Fredovsky/B13B-Nixie-clock/README.md

# B13B-Nixie-clock
Nixie clock made from F9057 Nixie tubes (B13B sockets).
