Fredovsky/B13B-Nixie-clock/Hardware/Nixie Clock Components V1 SMDPSU.xlsx

Nomenclature | Description | Package | Quantity | Part Number | Alternative PN | Pileofpoo Nomenclature
12V | Power Jack 2mm - D6.5mm |  | 1 | PJ-044A
C1 | 0.01uF 50V 10% Ceramic | 0603 | 1 | 885382206002 | C0603C103K5RAC7411 | C3
C2 | 680pF 50V 10% Ceramic | 0603 | 1 | C0603C681K5RACTU | CC0603KRX7R9BB681 | C2
C3-C10, C13-C15 | 0.1uF 25V | 0603 | 11 | 06033C104KAT4A | 06033G104ZAT4A
C11 | 10uF 25V | 0603 | 1 | GRM188R61E106KA73D | GRM188R61A106ME69D
~~C12~~ | ~~3.3uF 200V Al Electrolytic~~ | ~~Pitch 2.5mm x D6.3 x L11.2~~ | ~~1~~ | ~~ECA-2DM3R3~~ |  | ~~C4~~
C12 | 3.3uF 200V Al Electrolytic | SMD D8 L10 | 1 | UUX2D3R3MNL1GS |  | C4
C16 | 0.22uF 25V Ceramic | 0603 | 1 | 885012206073 | C1608X7R1E224K080AC
~~C17~~ | ~~220uF 25V Low ESR Electrolytic~~ | ~~Pitch 3.5mm xD8 x L11.5~~ | ~~1~~ | ~~EEU-FM1E221~~ |  | ~~C1~~
C17 | 220uF 25V Low ESR Electrolytic | SMD 6.6x6.6xH7.7 | 1 | EMZR250ADA221MF80G |  | C1
C18 | 100uF 25V decoupling capacitor | SMD 6.6x6.6xH7.7 | 1 | 865080545012
D1 | Small Signal Silicon Diode 4nS 1N4148 | SOD-123 | 1 | 1N4148W-7-F | 1N4148W-E3-18 | D2
~~D2~~ | ~~250PRV Ultra Fast Rectifier 50nS~~ | ~~SOD-123~~ | ~~1~~ | ~~BAV21HWFQ-7~~ | ~~BAV21W-E3-08~~ | ~~D1~~
D2 | 250PRV Ultra Fast Rectifier 50nS | TO-252-3 | 1 | RFN10BM3STL |  | D1
IC1 | 8bit Microcontroller | TQFP-32 | 1 | ATMEGA328P-AU
IC2 | 5V Voltage regulator | SOT223 | 1 | LM340MP-5.0/NOPB | LM7805MPX/NOPB
IC3 | 5V-12V CMOS Level shifter | TSSOP16 | 1 | CD4504BPWR | CD4504BPWE4
IC4 | Switch Mode Controller | SOIC8 | 1 | MC34063ADR | MC34063ADG | U1
ICSP | 2x3 0.1inch pin header |  | 1 | 61300621121 | TSW-103-24-L-D
JP1-JP3 | 2x8 0.1inch pin header male |  | 3 | 61301621121
JP1-JP3* | 2x8 0.1inch pin header female |  | 3 | 929852-01-08-RA | 803-87-016-10-001101
~~L1~~ | ~~100uH 1.4A Drum Core Inductor~~ | ~~Pitch 5mm x D9x L12.2~~ | ~~1~~ | ~~RLB9012-101KL~~ |  | ~~L1~~
L1 | 100uH 1.4A Drum Core Inductor | SMD 11x10xH4.8 | 1 | SDR1105-101KL |  | L1
~~Q1~~ | ~~60V PNP Transistor~~ | ~~TO-92 - Kinked leads~~ | ~~1~~ | ~~KSP2907ATA~~ | ~~KSP2907ACTA~~ | ~~Q2~~
Q1 | 60V PNP Transistor | SOT-23-3 | 1 | MMBT2907A-7-F |  | Q2
~~Q2~~ | ~~200V Power N-FET IPAK Height above PCB <10mm~~ | ~~TO251~~ | ~~1~~ | ~~IRFU220BTU-AM002~~ | ~~IRFU220NPBF~~ | ~~Q1~~
Q2 | 200V Power N-FET IPAK Height above PCB <10mm | TO-252-3 | 1 | IRFR220PBF |  | Q1
XTAL | 16Mhz 15pF Resonator |  | 1 | CSTNE16M0V530000R0
R1 | 13.7K 1/4W 1% | 1206 | 1 | CRCW120613K7FKEA | CR1206-FX-1372ELF | R4
R2 | 1K 1/4W 5% | 1206 | 1 | ERJ-8ENF1001V | CRCW12061K00FKEA | R3
R3 | 4.02K 1/4W 1% | 1206 | 1 | ERJ-8ENF4021V | CRCW12064K02FKEA | R6
R4 | 475K 1/4W 1% | 1206 | 1 | ERJ-8ENF4753V | RC1206FR-07475KL | R5
R5, R6 | 0.5Ohm 1/4W 5% | 1206 | 2 | RCWE1206R500FKEA | 560050332013 | R1, R2
R7, R10-R17 | 10K | 0603 | 9 | ESR03EZPJ103 | ESR03EZPF1002
~~R10~~ | ~~1K for safe luminance detection~~ | ~~0603~~ | ~~1~~ | ~~CRCW06031K00FKEAC~~ | ~~CRCW06031K00FKEA~~
R8, R9, R18, R19 | 4.7K | 0603 | 4 | ERJ-3EKF4701V | CRCW06034K70JNEBC
RX | 680Ohm 1% | 1206 | 1 | ERJ-UP8F6800V | CRCW1206680RFKEAC | RX
S1, S2, S3 | Tactile Switch, height>10mm |  | 3 | TL1105SPF160Q | TL1105SPF100Q
Switch cap | Tall black cap |  | 3 | 1RBLK
T1 | Ambiant Light Sensor |  | 1 | TEPT5700
U1, U2 | Tube driver | PQFP-44 | 2 | HV5530PG-G
RTC | Real Time Clock | SOIC16 | 1 | DS3231S#T&R
BAT | CR2032 Battery holder | SMD | 1 | BAT-HLD-001
RA1-RA4 | Anode Resistor 56k (or 47K or 30K) 2W 200V | 2010 | 4 | 350256KFT
Pins | Nixie to PCB pin (aliexpress/ebay) |  | 52
12V power adapteur | Plug 5.5mm x 2mm |  | 1 | SWI25-12-E-P5
M3 Standoffs (11mm) | Spacer for back board to control board |  | 2 | M2146-3005-AL
M4 Spacers (3mm) | Spacer for Nixie board to front wood | L3 Di 4.3 Do 6mm | 3 | M0532-4-AL
Hardware
Rubber feet | Hemispherical |  | 2 | SJ-5003
M4 Wood inserts | M4x8mm brass wood inserts |  | 3
M3x18screws | M3 for back board mount |  | 2
M4x12 screws | M4x12 |  | 3
M3 nuts |  |  | 2
CR2032 Battery |  |  | 1
