Fredovsky/B13B-Nixie-clock/Nixie Clock v1.1/3D Files/Nixie Clock for 3D Print v1.1.step

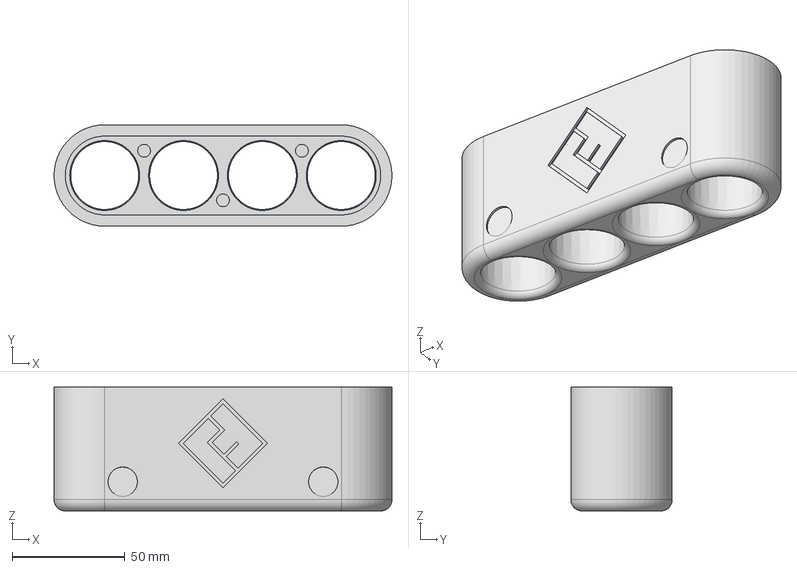
[picture p1: CAD file, 2025-10-16]
Nixie Clock v1.1/3D Files/Nixie Clock for 3D Print v1.1.step
150.0 x 45.0 x 55.0 mm
