Fredovsky/B13B-Nixie-clock/(list of files, cad)

Other CAD files:
Nixie Clock v1.1/3D Files/Nixie Clock for 3D Print v1.1.f3d
Nixie Clock v1.1/3D Files/Nixie Clock for 3D Print v1.1.stl
