Fredovsky/B13B-Nixie-clock/Nixie Clock v1.1/PCB/KiCAD project/ControllerBoardSMDPSU.kicad_pcb

## KiCad design Nixie Clock v1.1/PCB/KiCAD project/ControllerBoardSMDPSU.kicad_pcb (2025-10-16)

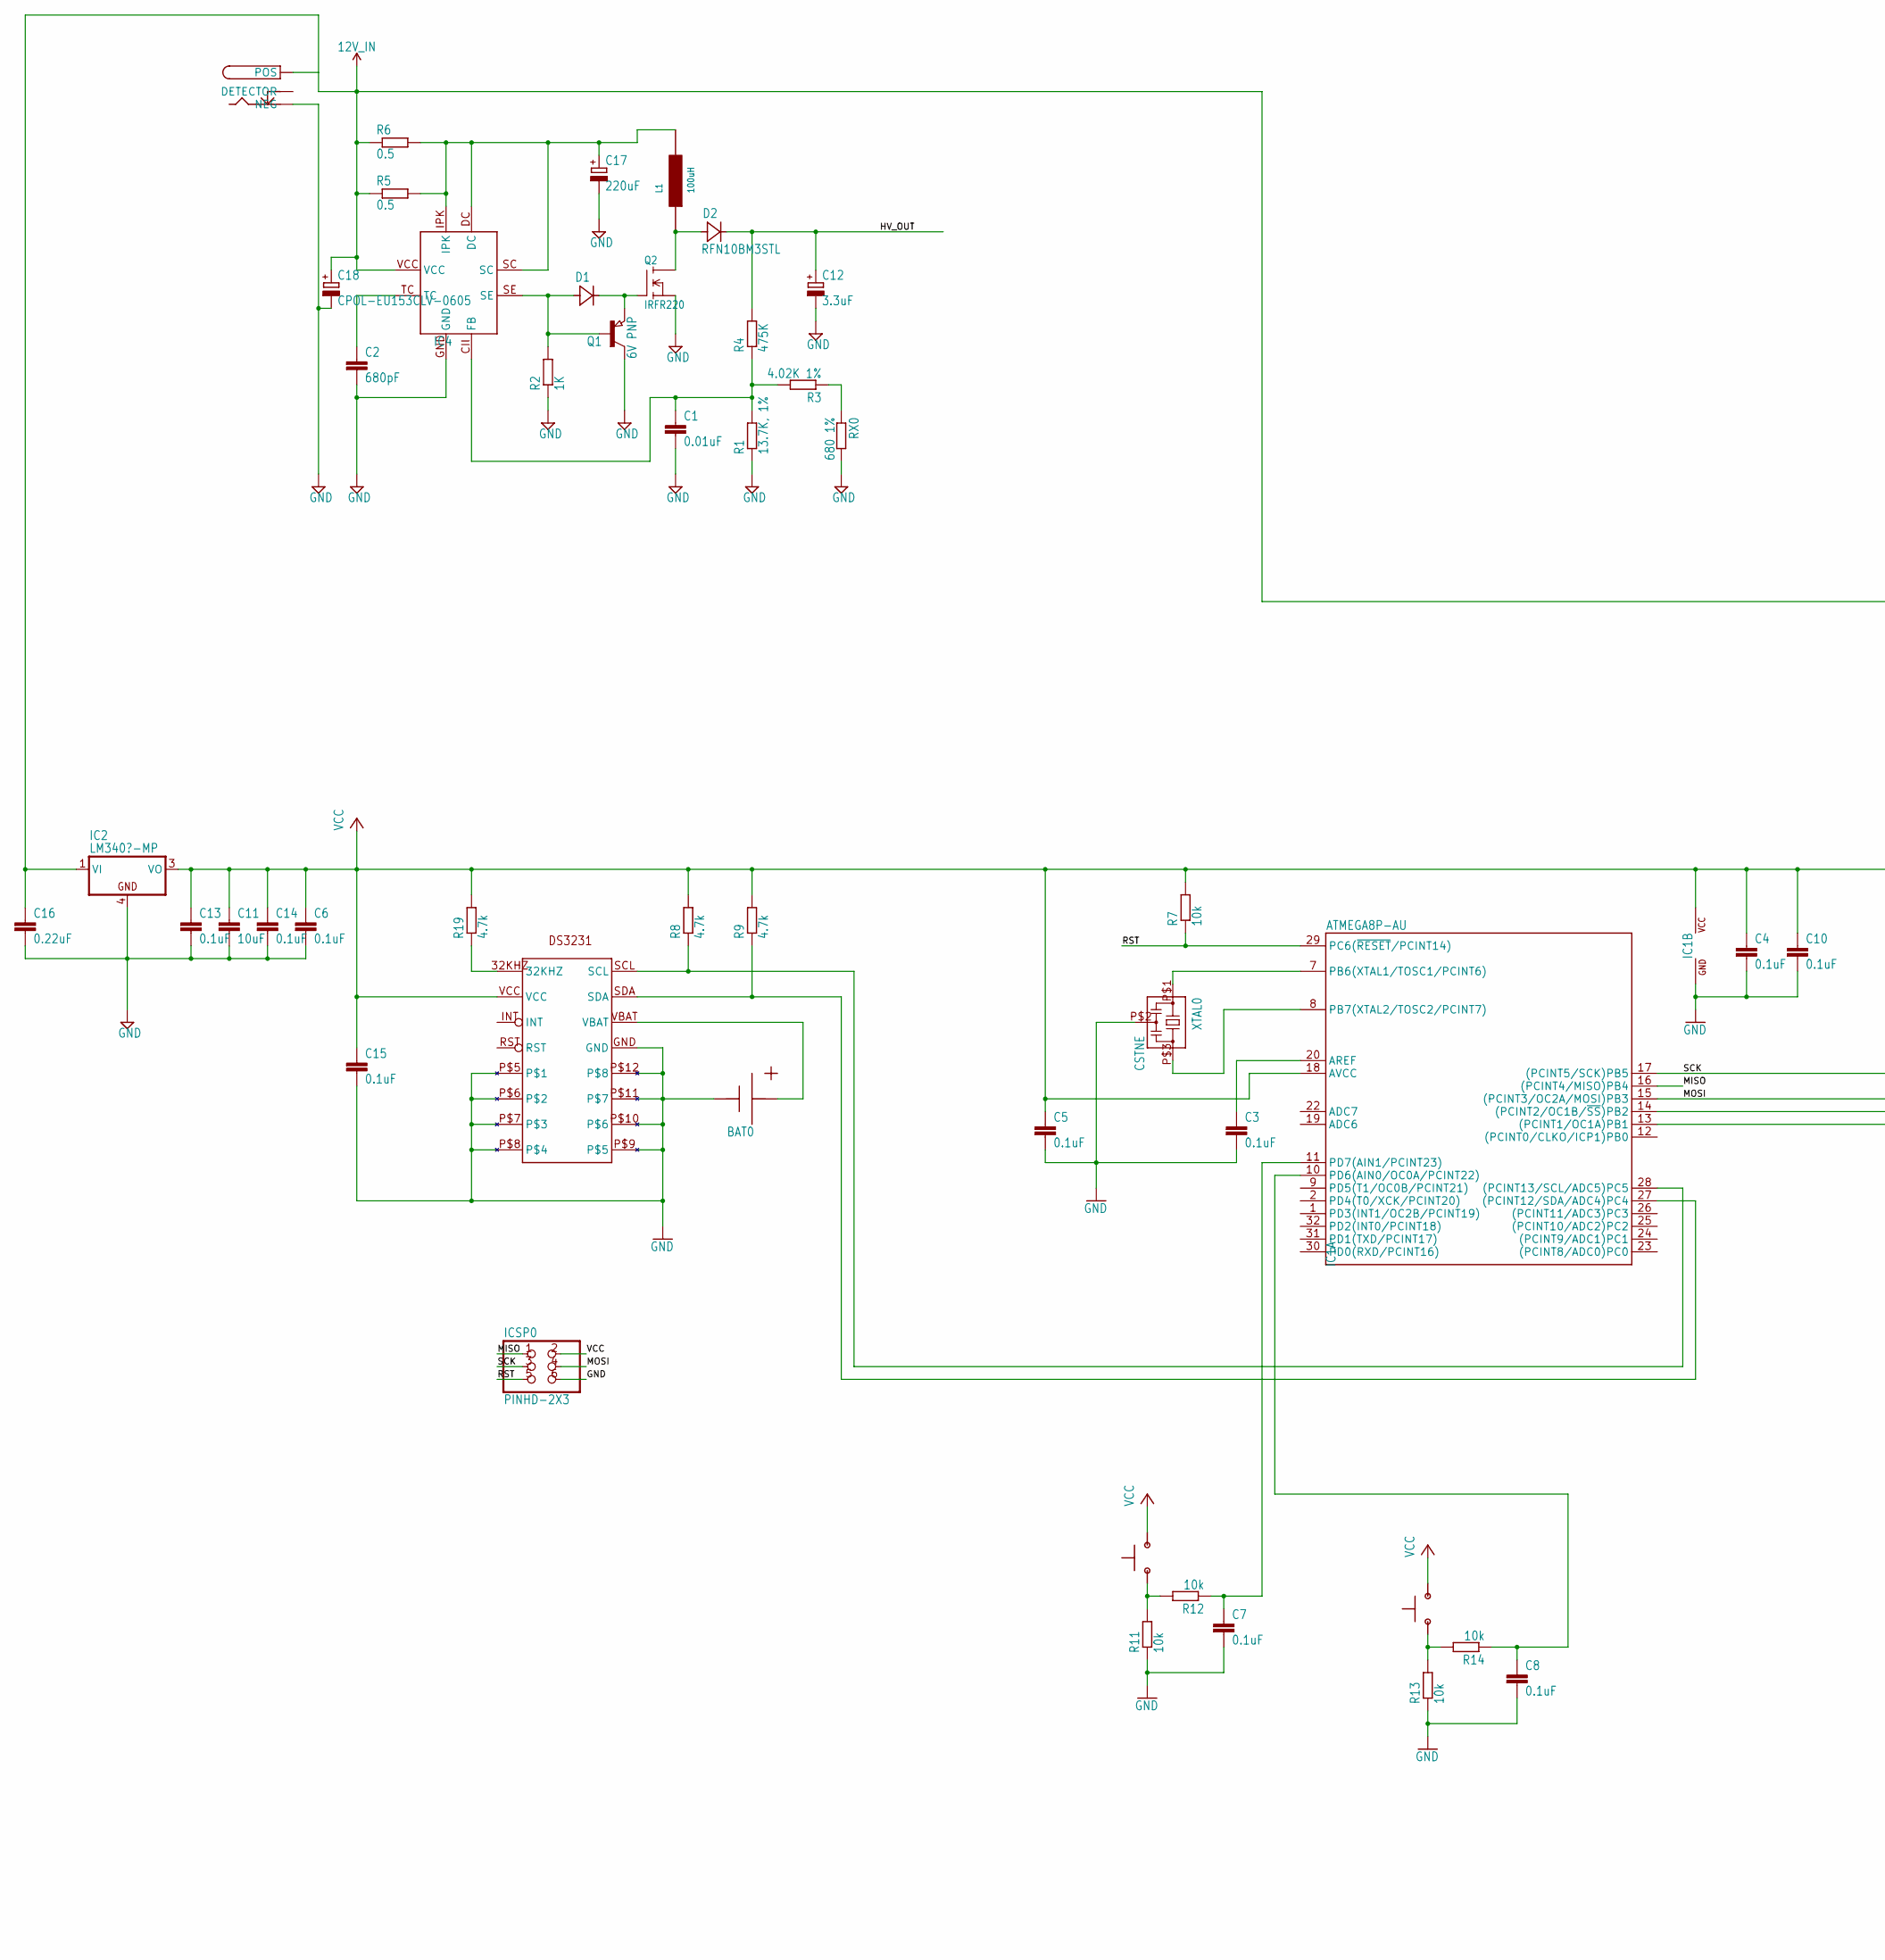
[picture p5: schematic ControllerBoardSMDPSU.kicad_sch, part in row 1, column 1]

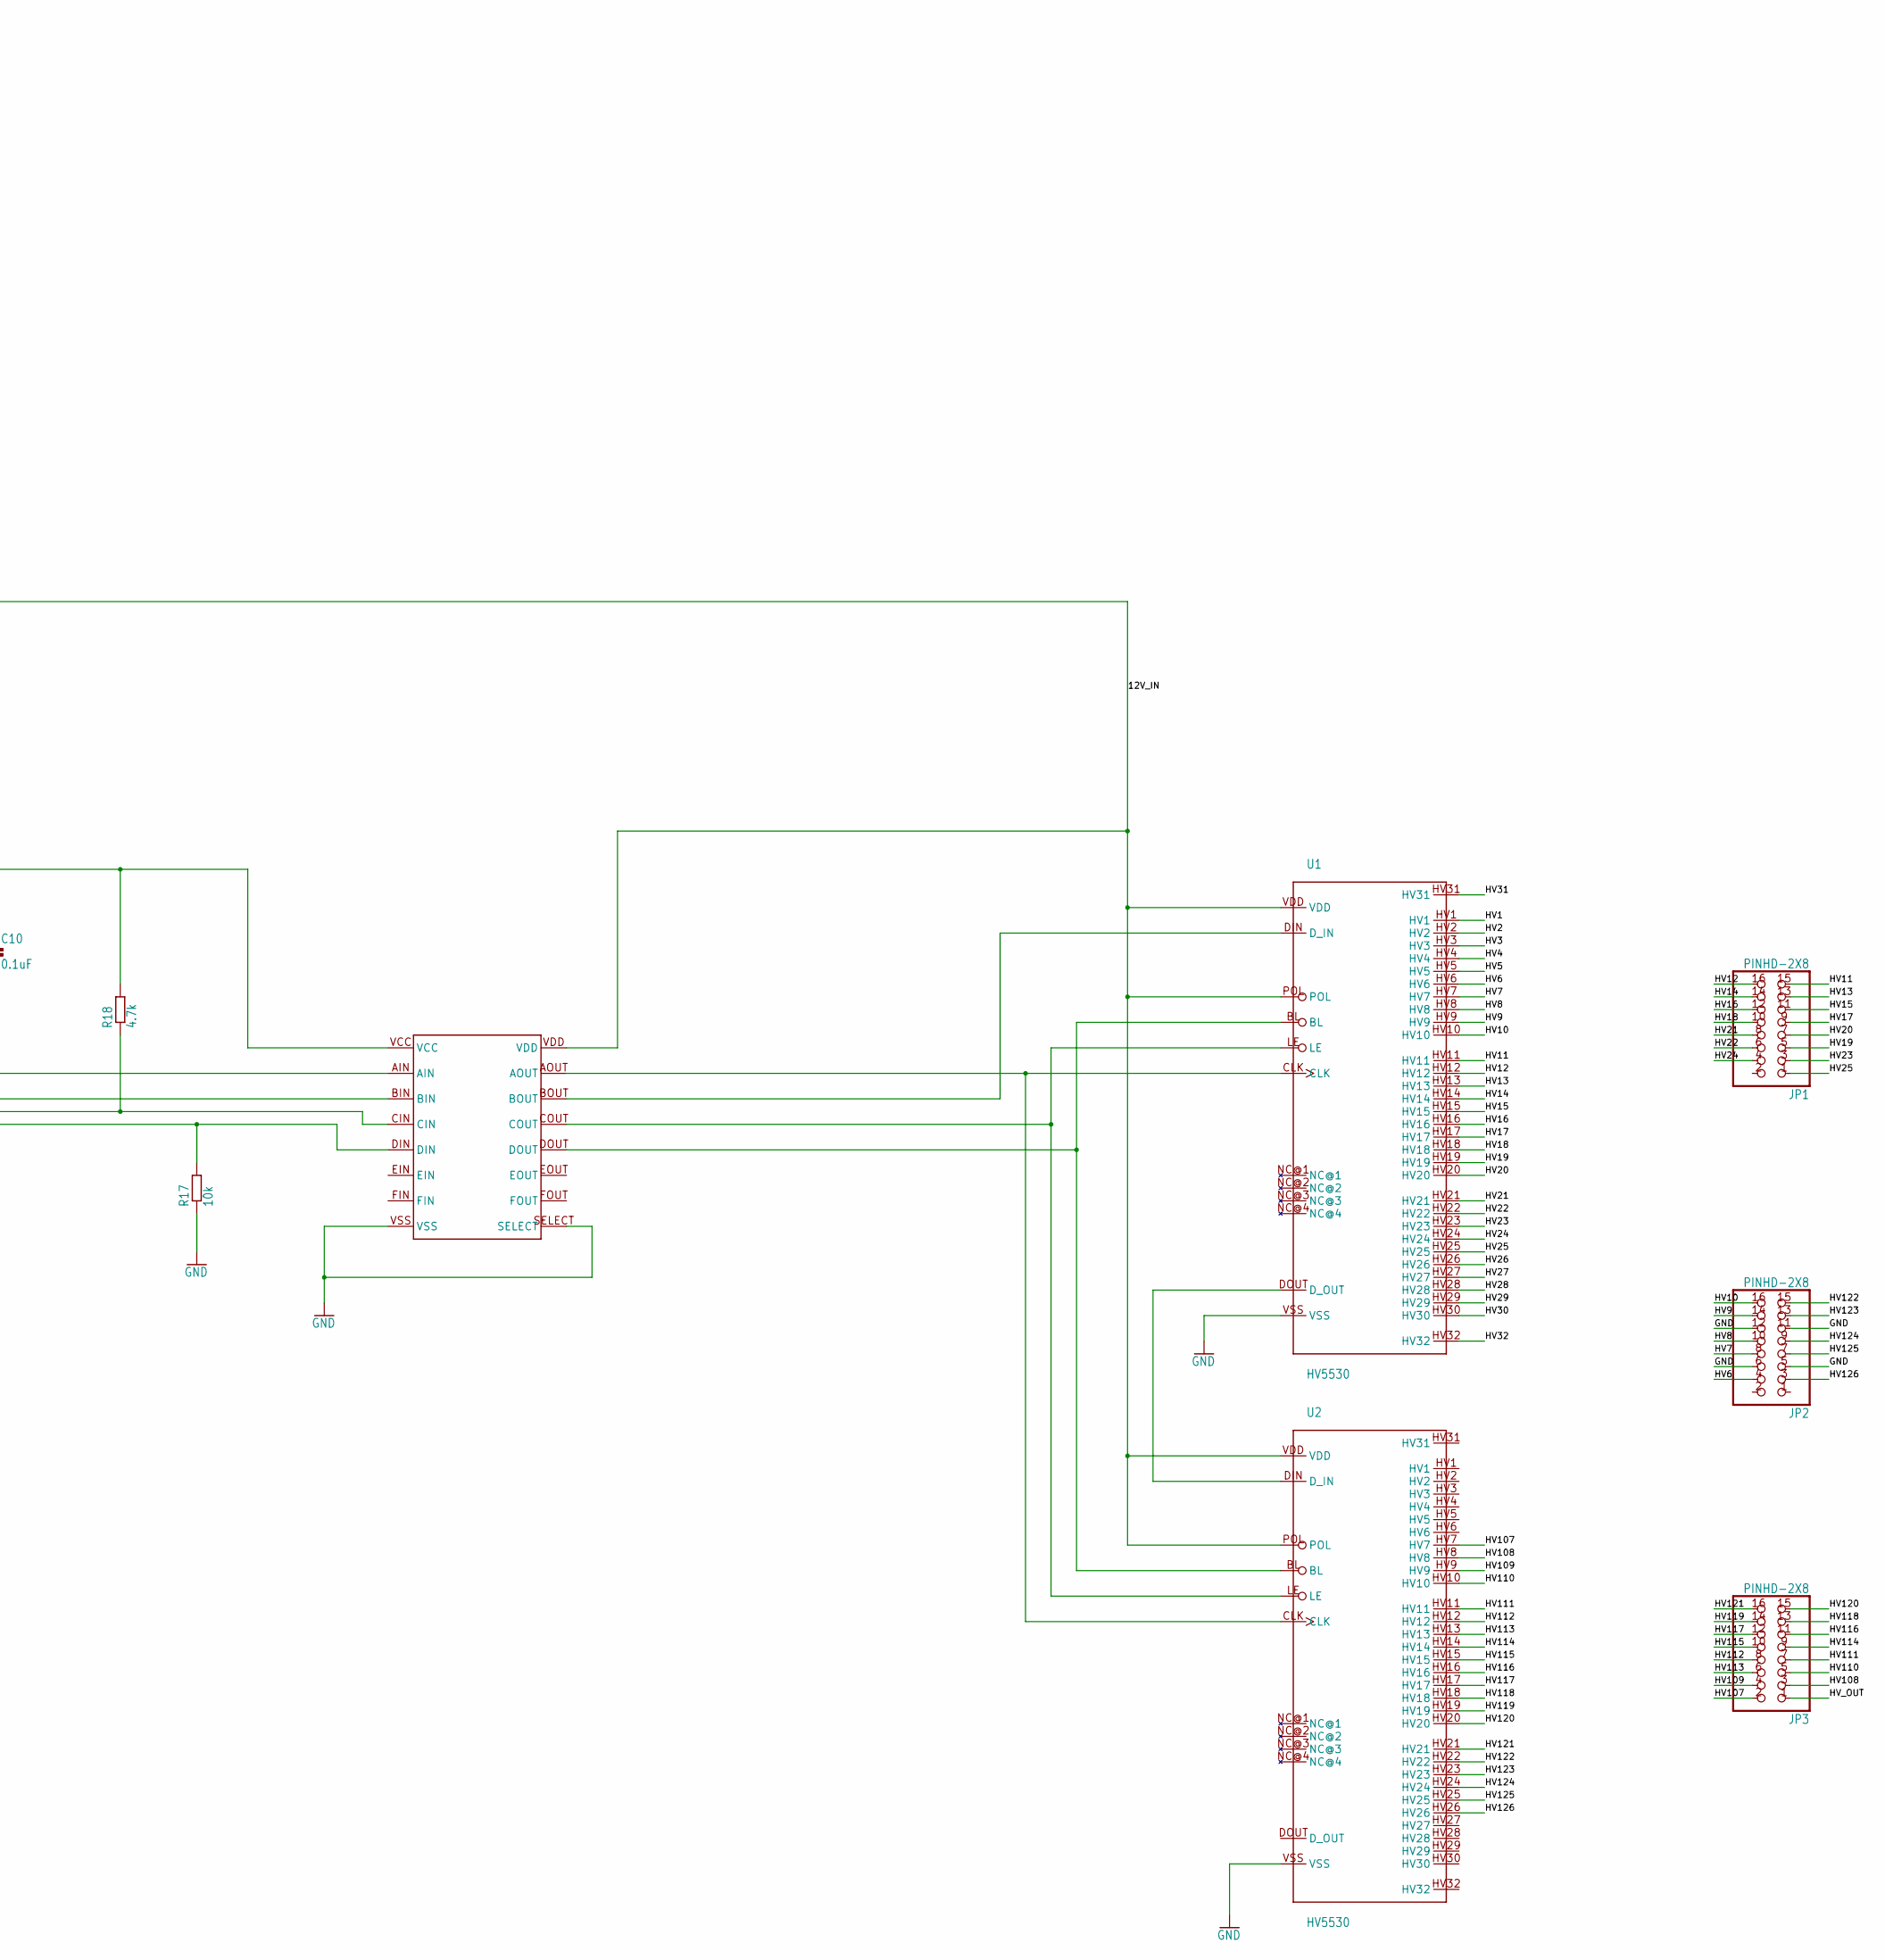
[picture p6: schematic ControllerBoardSMDPSU.kicad_sch, part in row 1, column 2]

Parts:
BAT0: CR2032-SMD-HLDR; CR2032-SMD
C1: 0.01uF; C0603
C2: 680pF; C0603
C3, C4, C5, C6, C7, C8, C10, C13, C14, C15: 0.1uF; C0603
C11: 10uF; C0603
C12: 3.3uF; 153CLV-0810
C16: 0.22uF; C0603
C17: 220uF; 153CLV-0605
C18: CPOL-EU153CLV-0605; 153CLV-0605
D1: SOT123DIODE; SOD123
D2: RFN10BM3STL; TO252
IC1: ATMEGA8P-AU; QFP32_7X7_0.80
IC2: LM340?-MP; SOT223
IC3: CD4504BTSSOP16; SOP65P640X120-16N
IC4: MC34063; SOIC127P600X175-8
ICSP0: PINHD-2X3; 2X03
JP1, JP2, JP3: PINHD-2X8; 2X08
L1: 100uH; SDR1105
Q1: 6V PNP; SOT23
Q2: IRFR220; DPAK
R1: 13.7K, 1%; R1206
R2: 1K; R1206
R3: 4.02K 1%; R1206
R4: 475K; R1206
R5, R6: 0.5; R1206
R7, R11, R12, R13, R14, R17: 10k; R0603
R8, R9, R18, R19: 4.7k; R0603
RTC0: DS3231-CORRECT; SOIC16-CORRECT
RX0: 680 1%; R1206
S1, S2: TL1105
U1, U2: HV5530; 44_PQFP_CORRECTED
UNK12V0: CUI_PWR_JACK
XTAL0: CSTNE

Connections:
12V_IN: C16.1, C18.+, IC2.1 (VI), IC3.VDD, IC4.VCC, R5.1, R6.1, U1.POL, U1.VDD, U2.POL, U2.VDD, UNK12V0.POS, UNK12V0.POS1 (POS); also elsewhere on the board
/HV1: U1.HV1
/HV2: U1.HV2
/HV3: U1.HV3
/HV4: U1.HV4
/HV5: U1.HV5
/HV6: JP2.4, U1.HV6
/HV7: JP2.8, U1.HV7
/HV8: JP2.10, U1.HV8
/HV9: JP2.14, U1.HV9
/HV10: JP2.16, U1.HV10
/HV11: JP1.15, U1.HV11
/HV12: JP1.16, U1.HV12
/HV13: JP1.13, U1.HV13
/HV14: JP1.14, U1.HV14
/HV15: JP1.11, U1.HV15
/HV16: JP1.12, U1.HV16
/HV17: JP1.9, U1.HV17
/HV18: JP1.10, U1.HV18
/HV19: JP1.5, U1.HV19
/HV20: JP1.7, U1.HV20
/HV21: JP1.8, U1.HV21
/HV22: JP1.6, U1.HV22
/HV23: JP1.3, U1.HV23
/HV24: JP1.4, U1.HV24
/HV25: JP1.1, U1.HV25
/HV26: U1.HV26
/HV27: U1.HV27
/HV28: U1.HV28
/HV29: U1.HV29
/HV30: U1.HV30
/HV31: U1.HV31
/HV32: U1.HV32
/HV107: JP3.2, U2.HV7
/HV108: JP3.3, U2.HV8
/HV109: JP3.4, U2.HV9
/HV110: JP3.5, U2.HV10
/HV111: JP3.7, U2.HV11
/HV112: JP3.8, U2.HV12
/HV113: JP3.6, U2.HV13
/HV114: JP3.9, U2.HV14
/HV115: JP3.10, U2.HV15
/HV116: JP3.11, U2.HV16
/HV117: JP3.12, U2.HV17
/HV118: JP3.13, U2.HV18
/HV119: JP3.14, U2.HV19
/HV120: JP3.15, U2.HV20
/HV121: JP3.16, U2.HV21
/HV122: JP2.15, U2.HV22
/HV123: JP2.13, U2.HV23
/HV124: JP2.9, U2.HV24
/HV125: JP2.7, U2.HV25
/HV126: JP2.3, U2.HV26
/HV_OUT: C12.+, D2.3 (C), JP3.1, R4.2
/MISO: IC1.16 ((PCINT4/MISO)PB4), ICSP0.1; also elsewhere on the board
/MOSI: IC1.15 ((PCINT3/OC2A/MOSI)PB3), IC3.BIN, ICSP0.4; also elsewhere on the board
/RST: IC1.29 (PC6(~RESET/PCINT14)), ICSP0.5, R7.1; also elsewhere on the board
/SCK: IC1.17 ((PCINT5/SCK)PB5), IC3.AIN, ICSP0.3; also elsewhere on the board
GND: BAT0.NEG, C1.2, C2.2, C3.2, C4.2, C5.2, C6.2, C7.2, C8.2, C10.2, C11.2, C12.-, C13.2, C14.2, C15.2, C16.2, C17.-, C18.-, IC1.3 (GND), IC1.5 (GND), IC1.21 (GND), IC2.4 (GND), IC3.SELECT, IC3.VSS, IC4.GND, ICSP0.6, JP2.5, JP2.6, JP2.11, JP2.12, Q1.3 (C), Q2.3 (S), R1.1, R2.1, R11.1, R13.1, R17.1, RTC0.GND, RTC0.P$5, RTC0.P$6, RTC0.P$7, RTC0.P$8, RTC0.P$9, RTC0.P$10, RTC0.P$11, RTC0.P$12, RX0.2, U1.VSS, U2.VSS, UNK12V0.NEG, UNK12V0.NEG1 (NEG), XTAL0.P$2 (2); also elsewhere on the board
unnamed 59: BAT0.POS@1 (POS), BAT0.POS@2 (POS), RTC0.VBAT; also elsewhere on the board
unnamed: C2.1, IC4.TC
unnamed: C17.+, IC4.DC, IC4.IPK, IC4.SC, L1.P$2, R5.2, R6.2
unnamed: D1.2 (A), IC4.SE, Q1.1 (B), R2.2
unnamed: D1.1 (C), Q1.2 (E), Q2.1 (G)
unnamed: IC1.13 ((PCINT1/OC1A)PB1), IC3.DIN, R17.2
unnamed: IC1.14 ((PCINT2/OC1B/~SS)PB2), IC3.CIN, R18.1
unnamed 66: IC1.27 ((PCINT12/SDA/ADC4)PC4), R9.1, RTC0.SDA; also elsewhere on the board
unnamed 67: IC1.28 ((PCINT13/SCL/ADC5)PC5), R8.1, RTC0.SCL; also elsewhere on the board
unnamed: C3.1, IC1.20 (AREF)
unnamed 69: IC1.7 (PB6(XTAL1/TOSC1/PCINT6)), XTAL0.P$1 (1); also elsewhere on the board
unnamed 70: IC1.8 (PB7(XTAL2/TOSC2/PCINT7)), XTAL0.P$3 (3); also elsewhere on the board
unnamed: C8.1, IC1.10 (PD6(AIN0/OC0A/PCINT22)), R14.1
unnamed: C7.1, IC1.11 (PD7(AIN1/PCINT23)), R12.1
unnamed: IC3.AOUT, U1.CLK, U2.CLK
unnamed: IC3.COUT, U1.LE, U2.LE
unnamed: IC3.DOUT, U1.BL, U2.BL
unnamed: C1.1, IC4.CII (FB), R1.2, R3.2, R4.1
unnamed: D2.1 (A), D2.2 (A), L1.P$1, Q2.2 (D)
unnamed 78: R3.1, RX0.1; also elsewhere on the board
unnamed: R11.2, R12.2, S1.1, S1.2
unnamed: R13.2, R14.2, S2.1, S2.2
unnamed 81: R19.1, RTC0.32KHZ; also elsewhere on the board
unnamed: IC3.BOUT, U1.DIN (D_IN)
unnamed: U1.DOUT (D_OUT), U2.DIN (D_IN)
unnamed: UNK12V0.DETECTOR, UNK12V0.DETECTOR1 (DETECTOR)
VCC: C4.1, C5.1, C6.1, C10.1, C11.1, C13.1, C14.1, C15.1, IC1.4 (VCC), IC1.6 (VCC), IC1.18 (AVCC), IC2.3 (VO), IC3.VCC, R7.2, R8.2, R9.2, R18.2, R19.2, RTC0.VCC, S1.3, S1.4, S2.3, S2.4; also elsewhere on the board

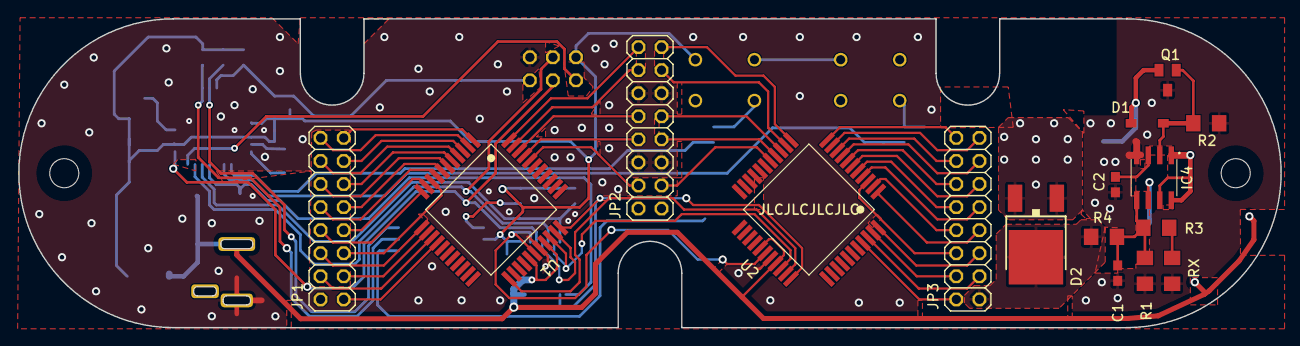
[picture p7: board ControllerBoardSMDPSU.kicad_pcb from above]

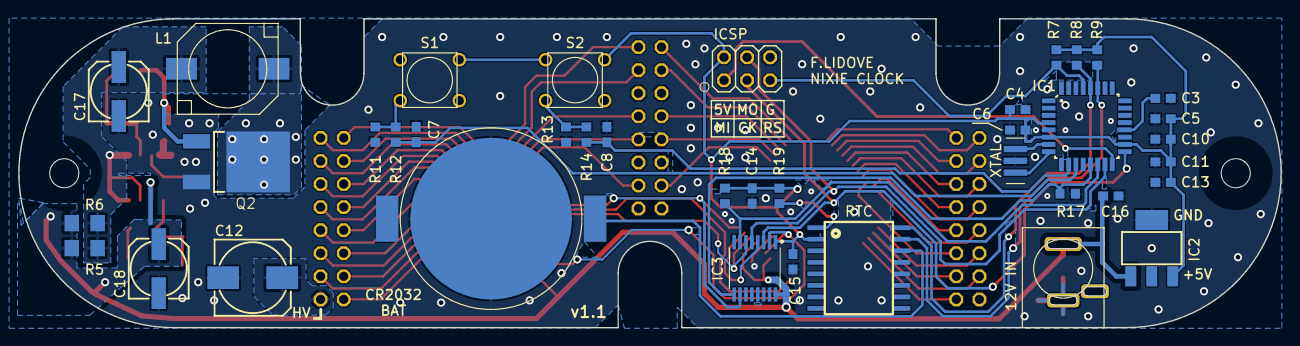
[picture p8: board ControllerBoardSMDPSU.kicad_pcb from below]

Board: 2 copper layers, 139.0 x 34.0 mm, 55 parts (39 on the bottom side), 74 nets.

Other parts of the board:
12V IN: CUI_PWR_JACK
ICSP: PINHD-2X3; 2X03_325
RTC: DS3231-CORRECT; SOIC16-CORRECT
RX: 680 1%; R1206_334
XTAL: CSTNE

Their connections:
12V_IN: 12V IN.POS, 12V IN.POS1 (POS); also elsewhere on the board
/MISO: ICSP.1; also elsewhere on the board
/MOSI: ICSP.4; also elsewhere on the board
/RST: ICSP.5; also elsewhere on the board
/SCK: ICSP.3; also elsewhere on the board
GND: 12V IN.NEG, 12V IN.NEG1 (NEG), ICSP.6, RTC.GND, RX.2, XTAL.P$2 (2); also elsewhere on the board
unnamed 59: RTC.VBAT; also elsewhere on the board
unnamed 66: RTC.SDA; also elsewhere on the board
unnamed 67: RTC.SCL; also elsewhere on the board
unnamed 69: XTAL.P$1 (1); also elsewhere on the board
unnamed 70: XTAL.P$3 (3); also elsewhere on the board
unnamed 78: RX.1; also elsewhere on the board
unnamed 81: RTC.32KHZ; also elsewhere on the board
unnamed: 12V IN.DETECTOR, 12V IN.DETECTOR1 (DETECTOR)
VCC: ICSP.2, RTC.VCC; also elsewhere on the board
