Fredovsky/B13B-Nixie-clock/Hardware/PCB v1/ControllerBoard.brd

## EAGLE design Hardware/PCB v1/ControllerBoard.brd (2021-03-23)

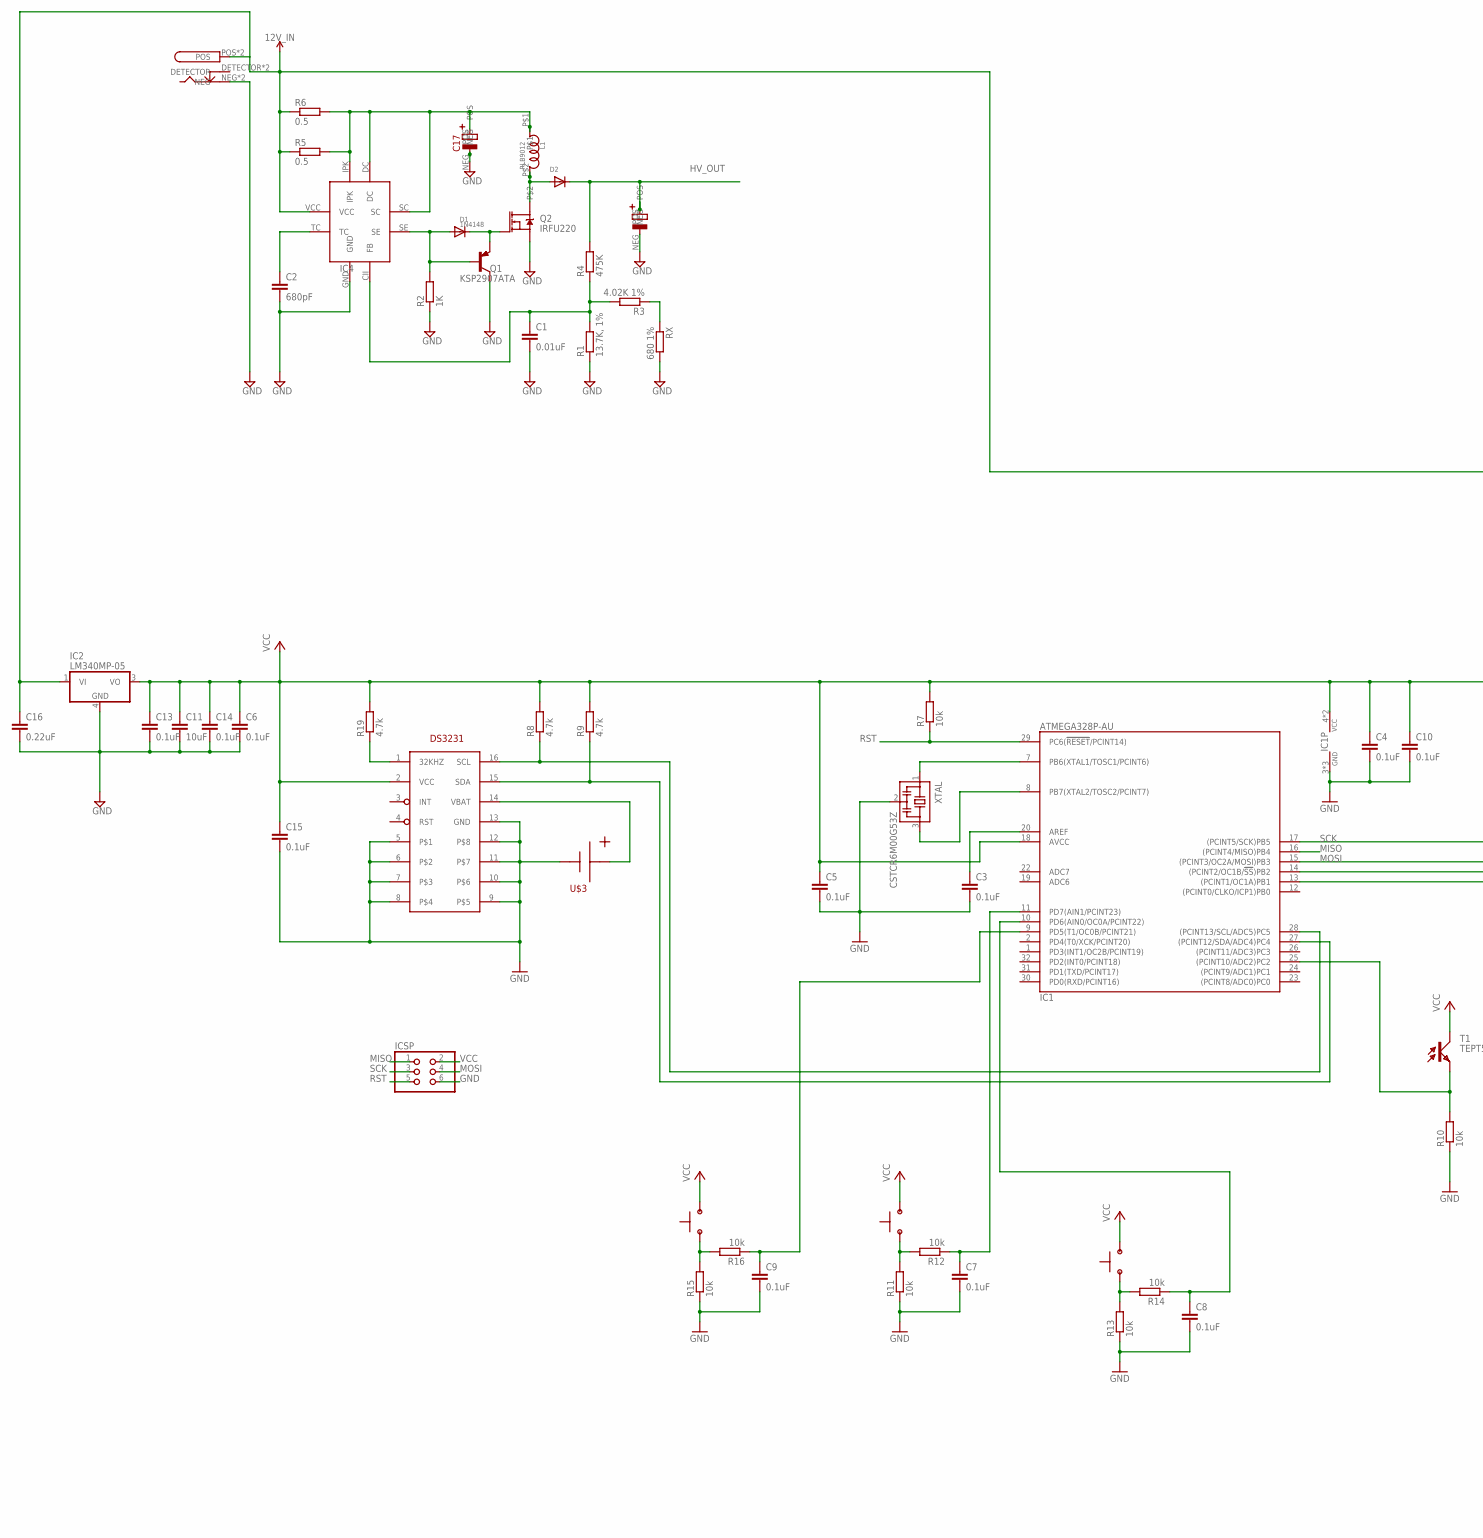
[picture p12: schematic ControllerBoard.sch, part in row 1, column 1]

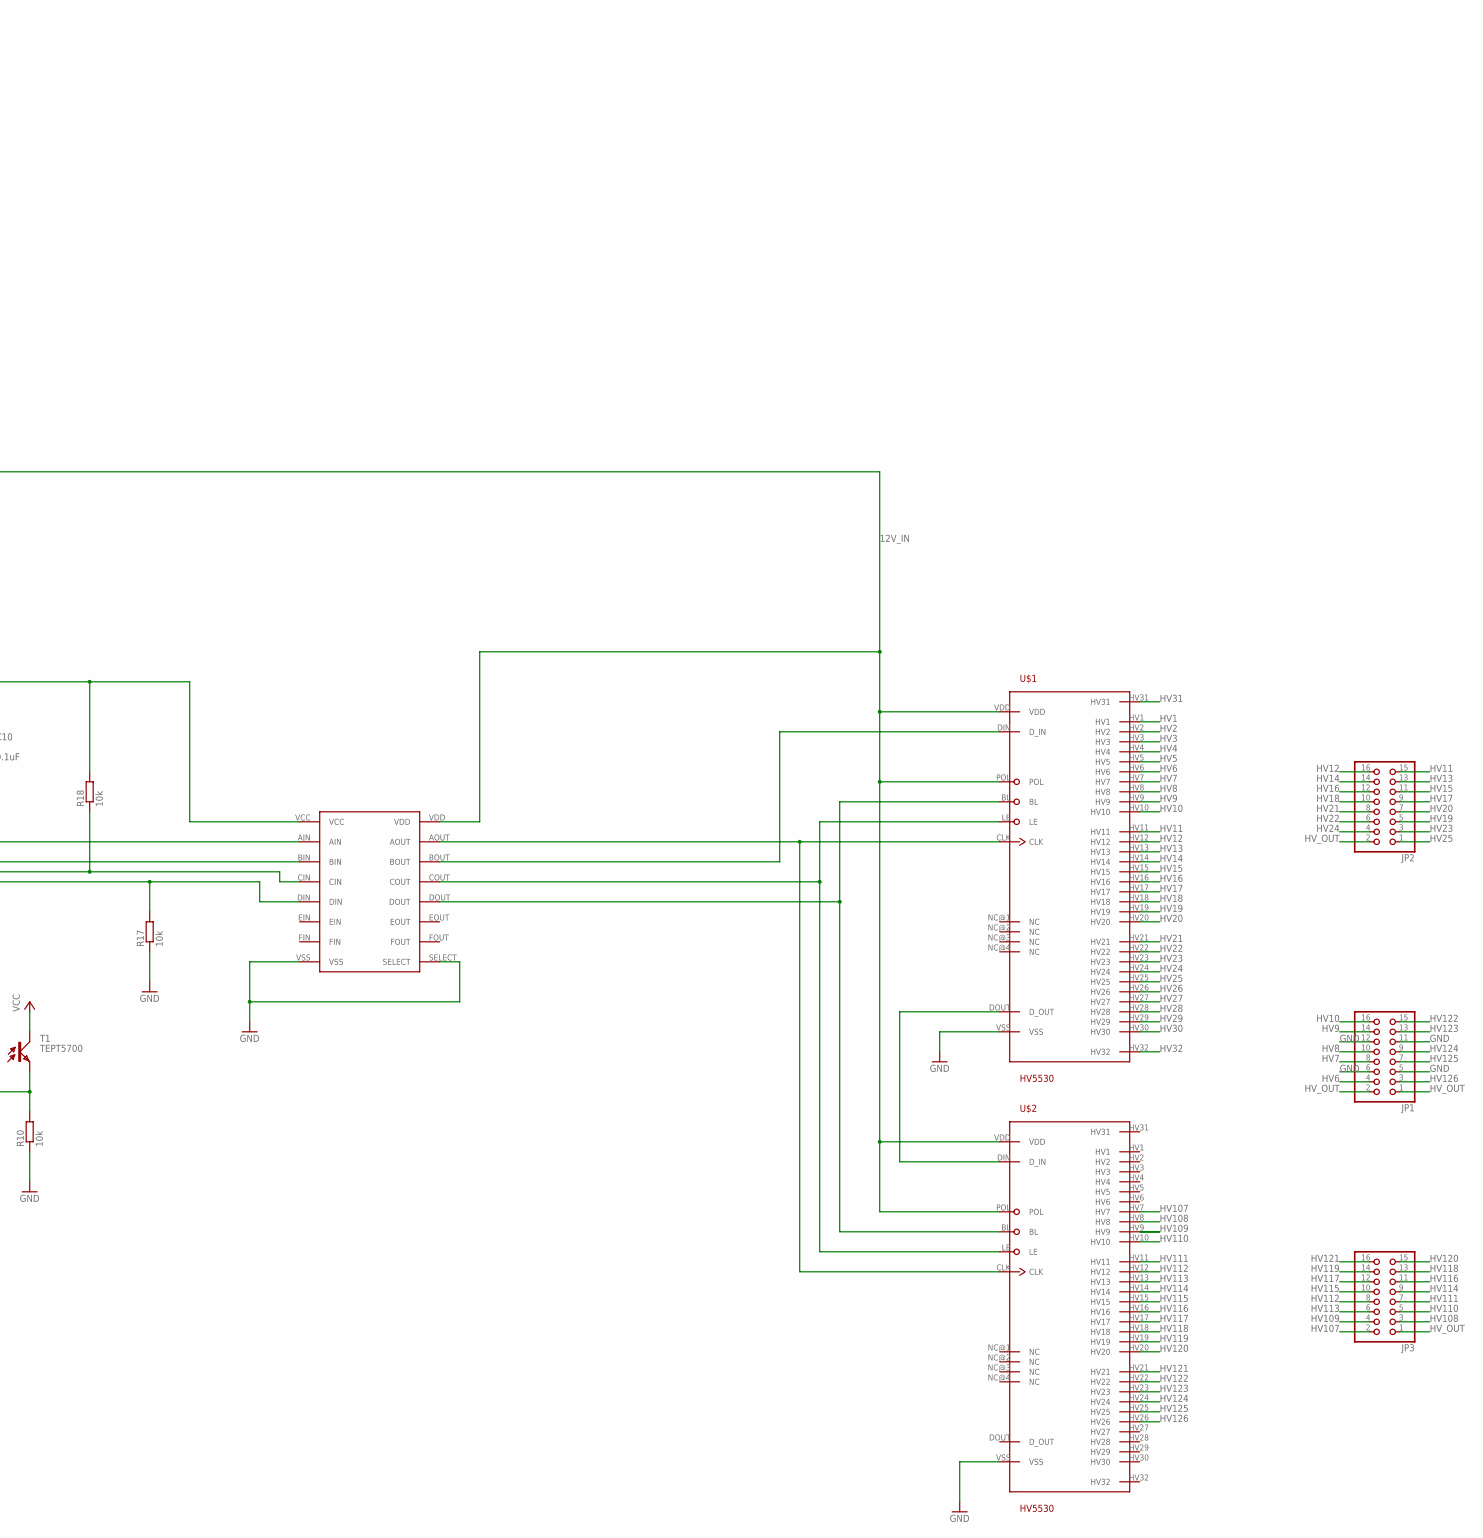
[picture p13: schematic ControllerBoard.sch, part in row 1, column 2]

Parts:
12V: CUI_PWR_JACK
C1: 0.01uF; C0603
C2: 680pF; C0603
C3, C4, C5, C6, C7, C8, C9, C10, C13, C14, C15: 0.1uF; C0603
C11: 10uF; C0603
C12: ECA-2DM3R3
C16: 0.22uF; C0603
C17: EEU-FM1
D1: 1N4148; SOD-123
D2: DIODESOD-123; SOD-123
IC1: ATMEGA328P-AU; QFP32_7X7_0.80
IC2: LM340MP-05; SOT223
IC3: CD4504BTSSOP16; SOP65P640X120-16N
IC4: MC34063; SOIC127P600X175-8
ICSP: PINHD-2X3; 2X03
JP1, JP2, JP3: PINHD-2X8; 2X08
L1: RLB9012
Q1: KSP2907ATA; TO92-EBC-OVAL
Q2: IRFU220; TO220V
R1: 13.7K, 1%; R1206
R2: 1K; R1206
R3: 4.02K 1%; R1206
R4: 475K; R1206
R5, R6: 0.5; R1206
R7, R10, R11, R12, R13, R14, R15, R16, R17, R18: 10k; R0603
R8, R9, R19: 4.7k; R0603
RTC: DS3231; SO16
RX: 680 1%; R1206
S1, S2, S3: TL1105
T1: TEPT5700; BPX81
U$1, U$2: HV5530; 44_PQFP_CORRECTED
U$3: CR2032-SMD-HLDR; CR2032-SMD
XTAL: CSTCR6M00G53Z; CSTCR6M

Connections:
12V_IN: 12V.POS, 12V.POS1 (POS), C16.1, IC2.1 (VI), IC3.VDD, IC4.VCC, R5.1, R6.1, U$1.POL, U$1.VDD, U$2.POL, U$2.VDD
GND: 12V.NEG, 12V.NEG1 (NEG), C1.2, C2.2, C3.2, C4.2, C5.2, C6.2, C7.2, C8.2, C9.2, C10.2, C11.2, C12.NEG, C13.2, C14.2, C15.2, C16.2, C17.NEG, IC1.3 (GND), IC1.5 (GND), IC1.21 (GND), IC2.4 (GND), IC3.SELECT, IC3.VSS, IC4.GND, ICSP.6, JP1.5, JP1.6, JP1.11, JP1.12, Q1.C, Q2.3 (S), R1.1, R2.1, R10.1, R11.1, R13.1, R15.1, R17.1, RTC.5, RTC.6, RTC.7, RTC.8, RTC.9, RTC.10, RTC.11, RTC.12, RTC.13 (GND), RX.2, U$1.VSS, U$2.VSS, U$3.NEG, XTAL.2
HV1: U$1.HV1
HV2: U$1.HV2
HV3: U$1.HV3
HV4: U$1.HV4
HV5: U$1.HV5
HV6: JP1.4, U$1.HV6
HV7: JP1.8, U$1.HV7
HV8: JP1.10, U$1.HV8
HV9: JP1.14, U$1.HV9
HV10: JP1.16, U$1.HV10
HV11: JP2.15, U$1.HV11
HV12: JP2.16, U$1.HV12
HV13: JP2.13, U$1.HV13
HV14: JP2.14, U$1.HV14
HV15: JP2.11, U$1.HV15
HV16: JP2.12, U$1.HV16
HV17: JP2.9, U$1.HV17
HV18: JP2.10, U$1.HV18
HV19: JP2.5, U$1.HV19
HV20: JP2.7, U$1.HV20
HV21: JP2.8, U$1.HV21
HV22: JP2.6, U$1.HV22
HV23: JP2.3, U$1.HV23
HV24: JP2.4, U$1.HV24
HV25: JP2.1, U$1.HV25
HV26: U$1.HV26
HV27: U$1.HV27
HV28: U$1.HV28
HV29: U$1.HV29
HV30: U$1.HV30
HV31: U$1.HV31
HV32: U$1.HV32
HV107: JP3.2, U$2.HV7
HV108: JP3.3, U$2.HV8
HV109: JP3.4, U$2.HV9
HV110: JP3.5, U$2.HV10
HV111: JP3.7, U$2.HV11
HV112: JP3.8, U$2.HV12
HV113: JP3.6, U$2.HV13
HV114: JP3.9, U$2.HV14
HV115: JP3.10, U$2.HV15
HV116: JP3.11, U$2.HV16
HV117: JP3.12, U$2.HV17
HV118: JP3.13, U$2.HV18
HV119: JP3.14, U$2.HV19
HV120: JP3.15, U$2.HV20
HV121: JP3.16, U$2.HV21
HV122: JP1.15, U$2.HV22
HV123: JP1.13, U$2.HV23
HV124: JP1.9, U$2.HV24
HV125: JP1.7, U$2.HV25
HV126: JP1.3, U$2.HV26
HV_OUT: C12.POS, D2.C, JP1.1, JP1.2, JP2.2, JP3.1, R4.2
MISO: IC1.16 ((PCINT4/MISO)PB4), ICSP.1
MOSI: IC1.15 ((PCINT3/OC2A/MOSI)PB3), IC3.BIN, ICSP.4
unnamed: RTC.14 (VBAT), U$3.POS@1 (POS), U$3.POS@2 (POS)
unnamed: IC1.7 (PB6(XTAL1/TOSC1/PCINT6)), XTAL.1
unnamed: IC1.8 (PB7(XTAL2/TOSC2/PCINT7)), XTAL.3
unnamed: R19.1, RTC.1 (32KHZ)
unnamed: IC3.AOUT, U$1.CLK, U$2.CLK
unnamed: U$1.DOUT (D_OUT), U$2.DIN (D_IN)
unnamed: IC3.BOUT, U$1.DIN (D_IN)
unnamed: C17.POS, IC4.DC, IC4.IPK, IC4.SC, L1.P$1, R5.2, R6.2
unnamed: C2.1, IC4.TC
unnamed: D1.A, IC4.SE, Q1.B, R2.2
unnamed: D1.C, Q1.E, Q2.1 (G)
unnamed: D2.A, L1.P$2, Q2.2 (D)
unnamed: C1.1, IC4.CII (FB), R1.2, R3.2, R4.1
unnamed: IC1.14 ((PCINT2/OC1B/!SS!)PB2), IC3.CIN, R18.1
unnamed: IC1.13 ((PCINT1/OC1A)PB1), IC3.DIN, R17.2
unnamed: IC3.COUT, U$1.LE, U$2.LE
unnamed: IC3.DOUT, U$1.BL, U$2.BL
unnamed: C3.1, IC1.20 (AREF)
unnamed: IC1.25 ((PCINT10/ADC2)PC2), R10.2, T1.E
unnamed: R3.1, RX.1
unnamed: R13.2, R14.2, S2.1, S2.2
unnamed: R11.2, R12.2, S1.1, S1.2
unnamed: C8.1, IC1.10 (PD6(AIN0/OC0A/PCINT22)), R14.1
unnamed: C7.1, IC1.11 (PD7(AIN1/PCINT23)), R12.1
unnamed: R15.2, R16.2, S3.1, S3.2
unnamed: C9.1, IC1.9 (PD5(T1/OC0B/PCINT21)), R16.1
RST: IC1.29 (PC6(!RESET!/PCINT14)), ICSP.5, R7.1
SCK: IC1.17 ((PCINT5/SCK)PB5), IC3.AIN, ICSP.3
SCL: IC1.28 ((PCINT13/SCL/ADC5)PC5), R8.1, RTC.16 (SCL)
SDA: IC1.27 ((PCINT12/SDA/ADC4)PC4), R9.1, RTC.15 (SDA)
VCC: C4.1, C5.1, C6.1, C10.1, C11.1, C13.1, C14.1, C15.1, IC1.4 (VCC), IC1.6 (VCC), IC1.18 (AVCC), IC2.3 (VO), IC3.VCC, ICSP.2, R7.2, R8.2, R9.2, R18.2, R19.2, RTC.2 (VCC), S1.3, S1.4, S2.3, S2.4, S3.3, S3.4, T1.C

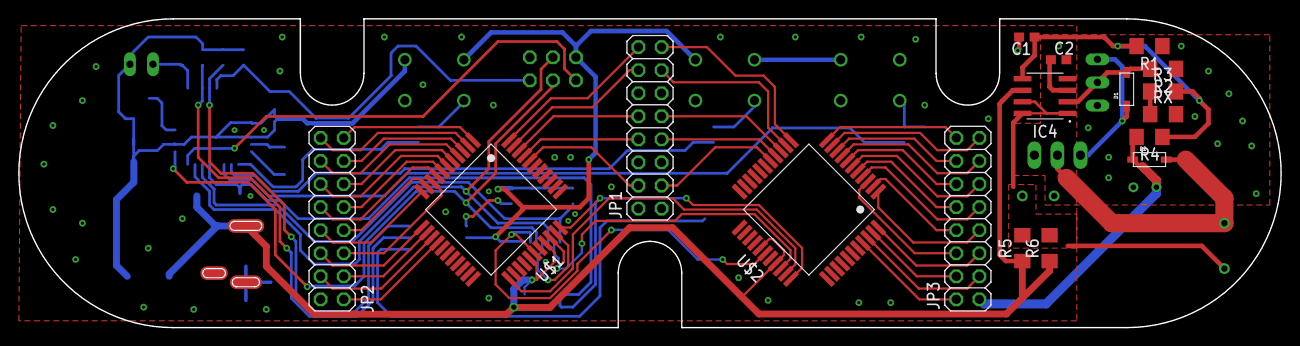
[picture p14: board ControllerBoard.brd from above]

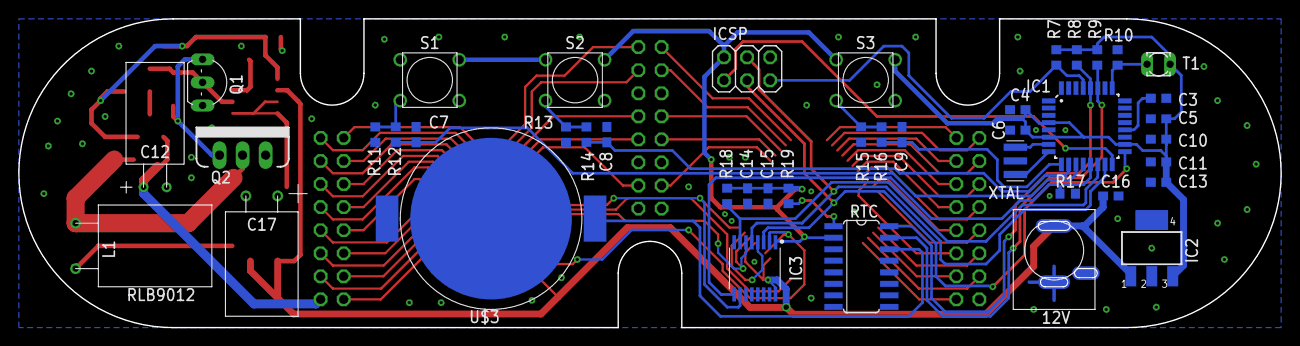
[picture p15: board ControllerBoard.brd from below]

Board: 2 copper layers, 139.0 x 34.0 mm, 60 parts (43 on the bottom side), 76 nets.
