Fredovsky/B13B-Nixie-clock/(commit log)

2021-03-23 Project creation
    Added all project files.
    [BackBoard.brd, BackBoard.sch, ControllerBoard.brd, ControllerBoard.sch, ControllerBoardPSUV2.brd, ControllerBoardPSUV2.sch, ControllerBoardSMDPSU.brd, ControllerBoardSMDPSU.sch]
2021-03-23 Reorganized files and added PCB BOM.
    Bill of materials added for V1 of the clock PCB using SMD for PSU.
    [BackBoard.brd, BackBoard.sch, ControllerBoard.brd, ControllerBoard.sch, ControllerBoardPSUV2.brd, ControllerBoardPSUV2.sch, ControllerBoardSMDPSU.brd, ControllerBoardSMDPSU.sch]
2021-12-12 First flash CPU clock bug fix
    RTCLib version added and CPU clock speed protocol for first upload.
    [main.cpp]
2021-12-23 Update main.cpp
    Long Cathode Poisoning Prevention Routine set for 30min at 3am, short routine every hour for 15 seconds.
    [main.cpp]
2025-10-16 Added v1.1
    v1.1 = modified Control board and back board for simpler 2-buttons set up (no more date/year functionnality as it was useless).
    PCBs now all on KiCAD.
    Added an updated BOM and 3D Print files if unable to make wooden case.
    [BackBoard.kicad_pcb, BackBoard.kicad_sch, ControllerBoardSMDPSU.kicad_pcb, ControllerBoardSMDPSU.kicad_sch, Nixie Clock for 3D Print v1.1.f3d, Nixie Clock for 3D Print v1.1.step, Nixie Clock for 3D Print v1.1.stl, NixieBoard.kicad_pcb]
2025-12-12 Set CPU frequency to 16MHz and configure fuses
    Updated CPU frequency to 16MHz and added fuse settings for external crystal.
2025-12-12 Update README for Nixie Clock v1.1 changes
    V1.1 update removes a push button and light sensor, changes back button functions, and adjusts brightness automatically.
2025-12-12 Refactor main.cpp for improved readability v1.1
    v1.1 Refactor main.cpp for improved readability and maintainability. Updated button handling, display logic, and constants for better clarity.
